linuslofgren/rice-box-hub/proposal/RIS_BOX_proposal-5/RIS_BOX_proposal-5-3.jpg

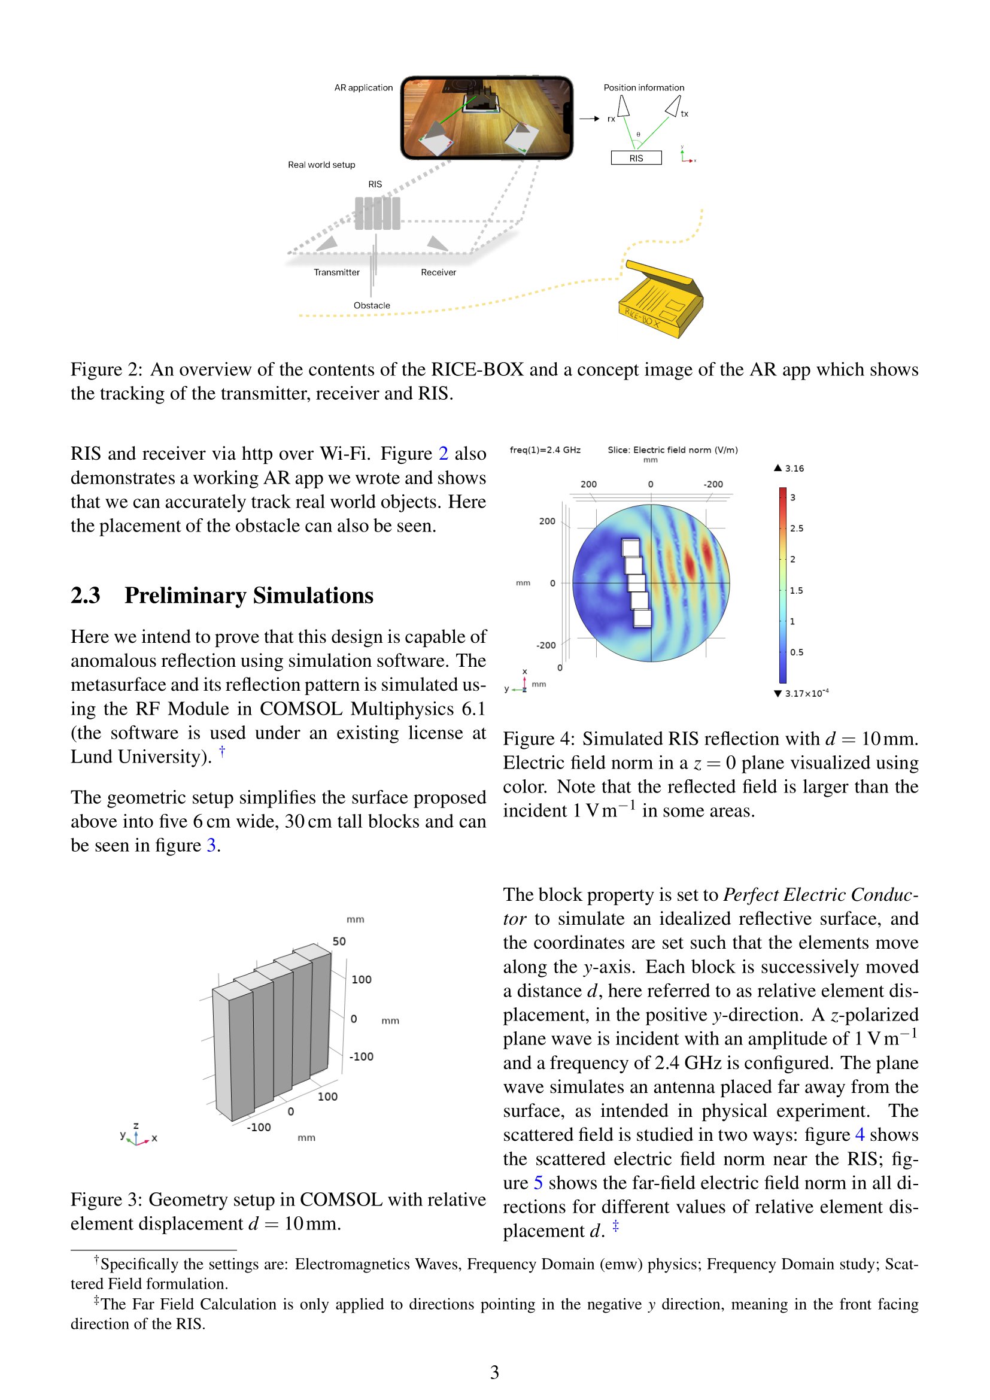
proposal/RIS_BOX_proposal-5/RIS_BOX_proposal-5-3.jpg
