linuslofgren/rice-box-hub/proposal/RIS_BOX_proposal-5/RIS_BOX_proposal-5-5.jpg

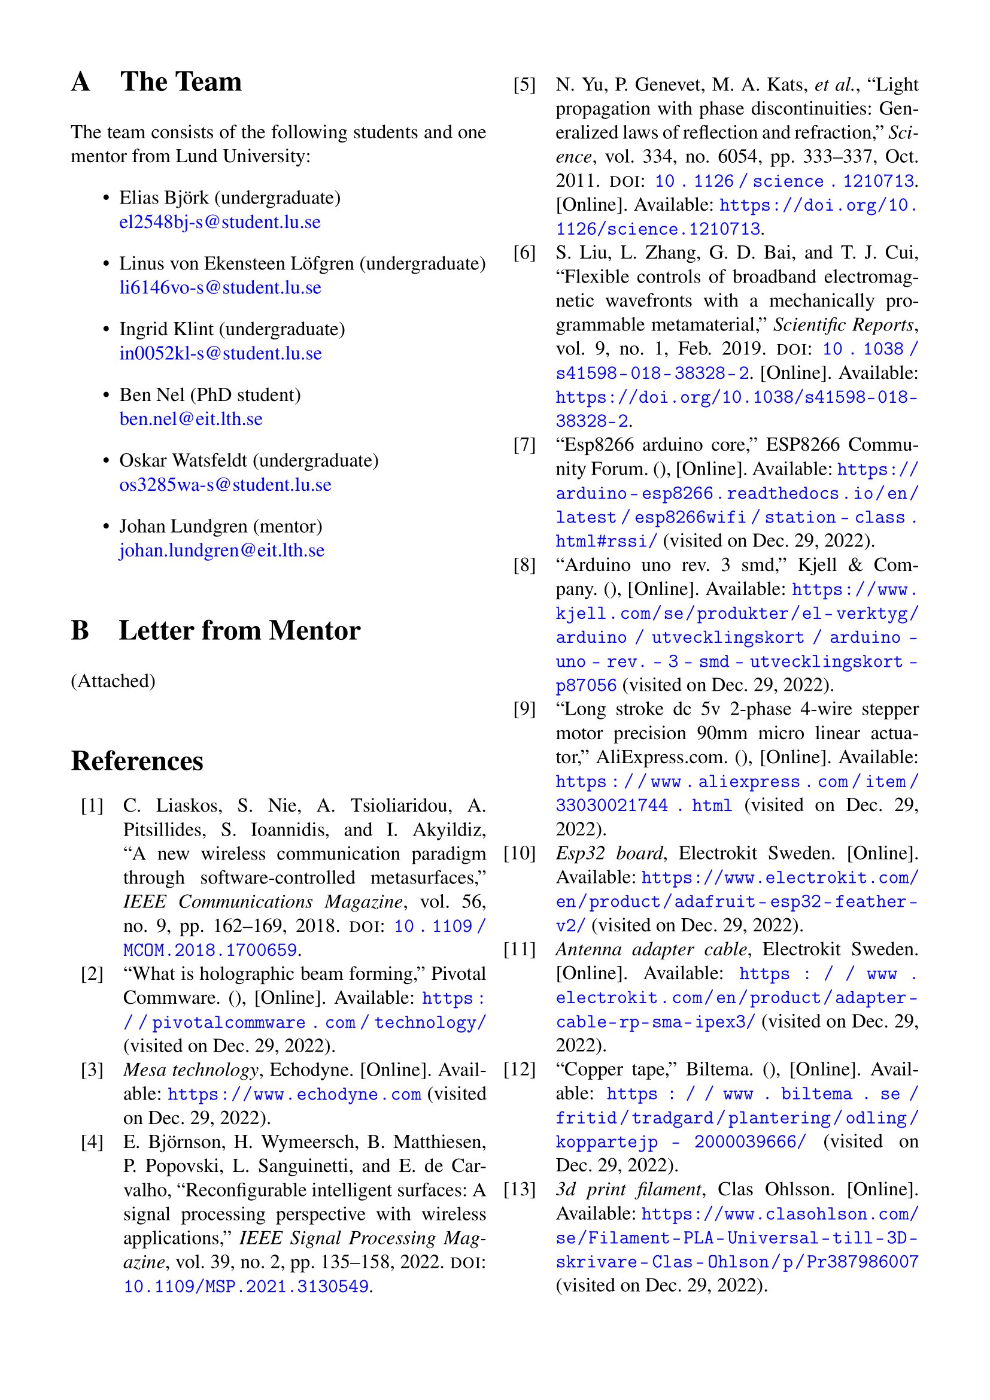
proposal/RIS_BOX_proposal-5/RIS_BOX_proposal-5-5.jpg
