linuslofgren/rice-box-hub/schematics/3D-printing/lid.stl

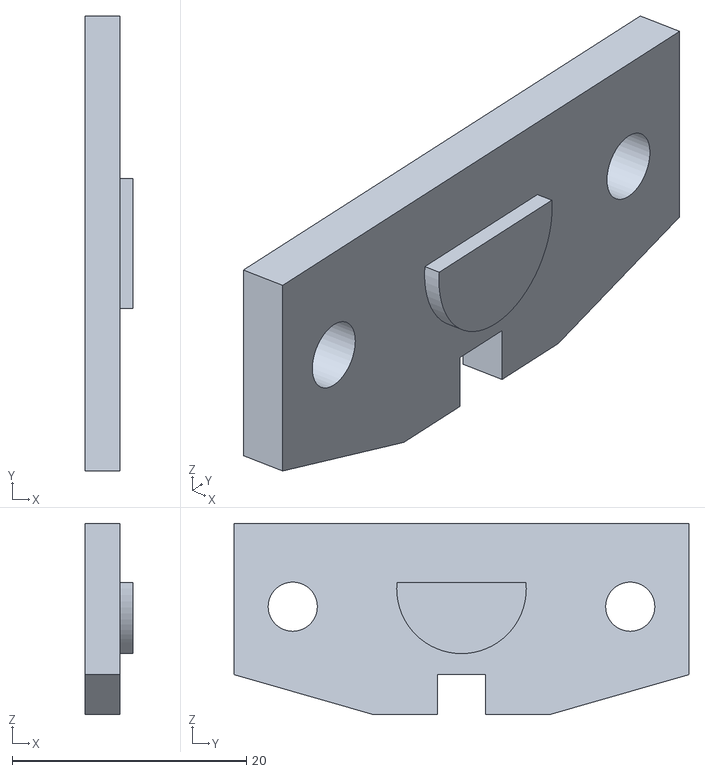
[picture p11: CAD file, 2023-06-12]
schematics/3D-printing/lid.stl
4.10 x 38.8 x 16.3
