linuslofgren/rice-box-hub/schematics/3D-printing/adapter.stl

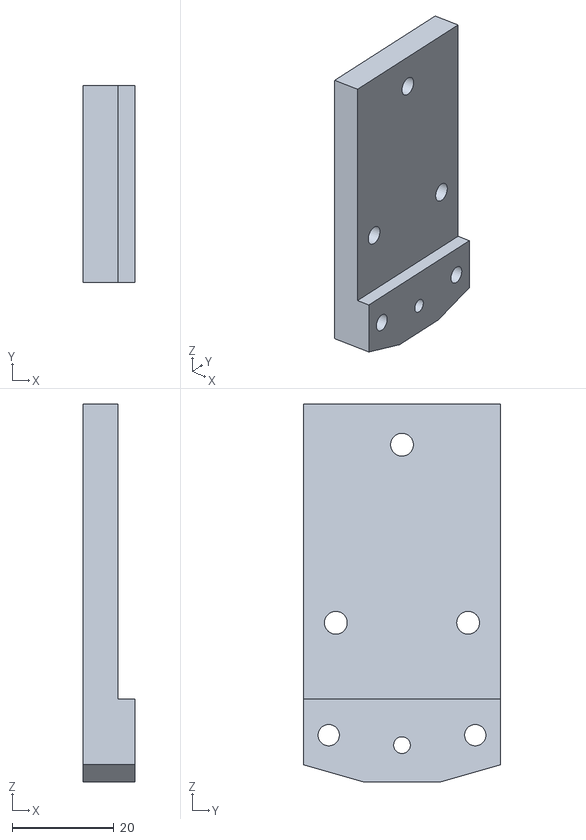
[picture p12: CAD file, 2023-06-12]
schematics/3D-printing/adapter.stl
10.3 x 38.8 x 74.3
