linuslofgren/rice-box-hub/(list of files, cad)

Other CAD files:
schematics/RIS-fusion360.f3d
