linuslofgren/rice-box-hub/(commit log)

2023-04-08 socket for interfacing with the hub
2023-04-08 Separate server and web components (+ add WebSocket and UDS socket interop)
2023-04-08 Add socket to .gitignore
2023-04-11 Deno-Julia Socket: Fix socket interconnect issues and add error handling
2023-04-11 restructured couple function + ObjectPositions type
2023-04-13 Socket operation types: Add more correct typescript notation
2023-04-16 arduino start
2023-05-07 arduino: add class representation of stepper
2023-05-15 arduino: add high level linear actuator interface
2023-05-15 arduino: add default constructors
2023-05-15 arduino: draft main
2023-05-31 add needed things for interrupthandler
2023-05-31 Arduino: Measurement fixes
2023-06-03 data and freely optimized displacements
    [free_config.txt]
2023-06-03 added motor mount file
2023-06-11 move construction-files -> schematics
2023-06-12 adding Fusion 360 files
    [RIS-fusion360.f3d, adapter.stl, lid.stl]
2023-07-17 Forwarding acknowledgement when Arduino finished moving, make mock for arduino. Custom little protocol
2023-07-20 teaking optimize, can flip orientation of bars. Zeroing LinAcs
    [LinearActuator.cpp, arduino.ino]
2023-07-23 fixed mock, movable graph, broadcasting
    [main_mock.rs]
2023-07-24 Solved multiple sockets open problem
